MaxRanger/Satellite-Tracker/PCB/HostBoard/HostBoard_PowerPlane.kicad_pcb

## KiCad design PCB/HostBoard/HostBoard_PowerPlane.kicad_pcb (2025-11-15)

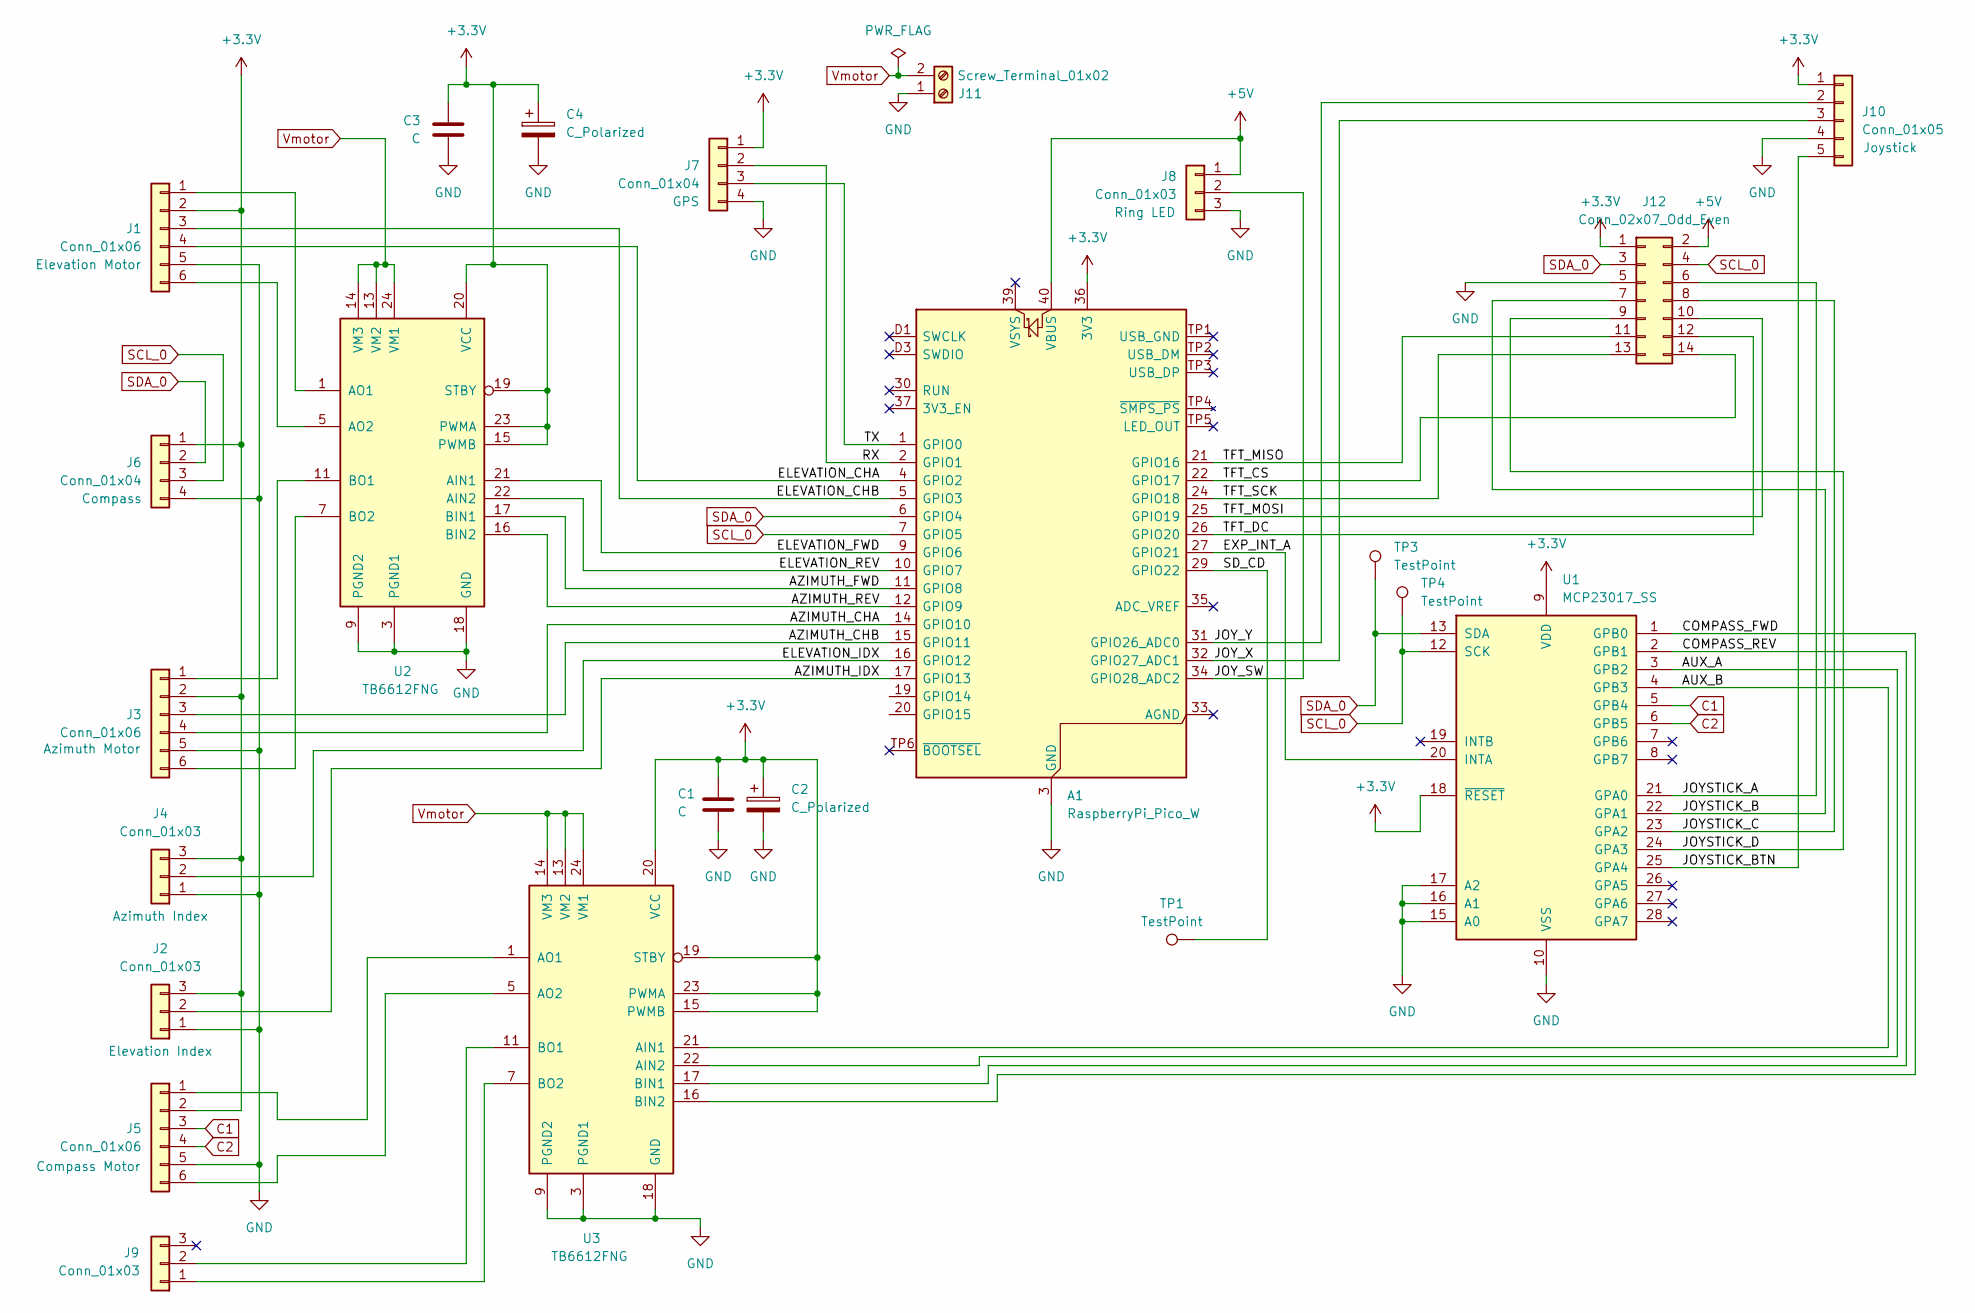
[picture p1: schematic HostBoard_PowerPlane.kicad_sch]

Parts:
A1: RaspberryPi_Pico_W; RaspberryPi_Pico_Common_THT
C1, C3: C; C_0805_2012Metric_Pad1.18x1.45mm_HandSolder
C2, C4: C_Polarized; C_0805_2012Metric_Pad1.18x1.45mm_HandSolder
J1, J3, J5: Conn_01x06; JST_EH_S6B-EH_1x06_P2.50mm_Horizontal
J2, J4, J8: Conn_01x03; JST_EH_S3B-EH_1x03_P2.50mm_Horizontal
J6, J7: Conn_01x04; JST_EH_S4B-EH_1x04_P2.50mm_Horizontal
J9: Conn_01x03; PinHeader_1x03_P2.54mm_Vertical
J10: Conn_01x05; JST_EH_S5B-EH_1x05_P2.50mm_Horizontal
J11: Screw_Terminal_01x02; TerminalBlock_Xinya_XY308-2.54-2P_1x02_P2.54mm_Horizontal
J12: Conn_02x07_Odd_Even; PinHeader_2x07_P2.54mm_Vertical
TP1: TestPoint; PinHeader_1x01_P2.54mm_Vertical
TP3, TP4: TestPoint; TestPoint_Pad_1.0x1.0mm
U1: MCP23017_SS; SSOP-28_5.3x10.2mm_P0.65mm
U2, U3: TB6612FNG; SSOP-24_5.3x8.2mm_P0.65mm

Connections:
+3.3V: A1.36 (3V3), C1.1, C2.1, C3.1, C4.1, J1.2, J2.3, J3.2, J4.3, J5.2, J6.1, J7.1, J10.1, J12.1, U1.9 (VDD), U1.18 (~RESET), U2.15 (PWMB), U2.19 (STBY), U2.20 (VCC), U2.23 (PWMA), U3.15 (PWMB), U3.19 (STBY), U3.20 (VCC), U3.23 (PWMA)
+5V: A1.40 (VBUS), J8.1, J12.2
/AZIMUTH_CHA: A1.14 (GPIO10), J3.4
/AZIMUTH_CHB: A1.15 (GPIO11), J3.3
/AZIMUTH_FWD: A1.11 (GPIO8), U2.17 (BIN1)
/AZIMUTH_IDX: A1.17 (GPIO13), J2.2
/AZIMUTH_REV: A1.12 (GPIO9), U2.16 (BIN2)
/ELEVATION_CHA: A1.4 (GPIO2), J1.4
/ELEVATION_CHB: A1.5 (GPIO3), J1.3
/ELEVATION_FWD: A1.9 (GPIO6), U2.21 (AIN1)
/ELEVATION_IDX: A1.16 (GPIO12), J4.2
/ELEVATION_REV: A1.10 (GPIO7), U2.22 (AIN2)
/EXP_INT_A: A1.27 (GPIO21), U1.20 (INTA)
/JOY_SW: A1.34 (GPIO28_ADC2), J8.2
/JOY_X: A1.32 (GPIO27_ADC1), J10.3
/JOY_Y: A1.31 (GPIO26_ADC0), J10.2
/RX: A1.2 (GPIO1), J7.2
/SD_CD: A1.29 (GPIO22), TP1.1
/TFT_CS: A1.22 (GPIO17), J12.14
/TFT_DC: A1.26 (GPIO20), J12.12
/TFT_MISO: A1.21 (GPIO16), J12.11
/TFT_MOSI: A1.25 (GPIO19), J12.10
/TFT_SCK: A1.24 (GPIO18), J12.13
/TX: A1.1 (GPIO0), J7.3
C1: J5.3, U1.5 (GPB4)
C2: J5.4, U1.6 (GPB5)
GND: A1.3 (GND), A1.8 (GND), A1.13 (GND), A1.18 (GND), A1.23 (GND), A1.28 (GND), A1.38 (GND), A1.D2 (GND), C1.2, C2.2, C3.2, C4.2, J1.5, J2.1, J3.5, J4.1, J5.5, J6.4, J7.4, J8.3, J10.4, J11.1, J12.5, U1.10 (VSS), U1.15 (A0), U1.16 (A1), U1.17 (A2), U2.3 (PGND1), U2.4 (PGND1), U2.9 (PGND2), U2.10 (PGND2), U2.18 (GND), U3.3 (PGND1), U3.4 (PGND1), U3.9 (PGND2), U3.10 (PGND2), U3.18 (GND)
unnamed: J1.1, U2.1 (AO1), U2.2 (AO1)
unnamed: J1.6, U2.5 (AO2), U2.6 (AO2)
unnamed: J3.1, U2.11 (BO1), U2.12 (BO1)
unnamed: J3.6, U2.7 (BO2), U2.8 (BO2)
unnamed: J5.1, U3.1 (AO1), U3.2 (AO1)
unnamed: J5.6, U3.5 (AO2), U3.6 (AO2)
unnamed: J9.1, U3.7 (BO2), U3.8 (BO2)
unnamed: J9.2, U3.11 (BO1), U3.12 (BO1)
unnamed: J10.5, U1.25 (GPA4)
unnamed: J12.6, U1.21 (GPA0)
unnamed: J12.7, U1.22 (GPA1)
unnamed: J12.8, U1.23 (GPA2)
unnamed: J12.9, U1.24 (GPA3)
unnamed: U1.1 (GPB0), U3.16 (BIN2)
unnamed: U1.2 (GPB1), U3.17 (BIN1)
unnamed: U1.3 (GPB2), U3.22 (AIN2)
unnamed: U1.4 (GPB3), U3.21 (AIN1)
SCL_0: A1.7 (GPIO5), J6.3, J12.4, TP4.1, U1.12 (SCK)
SDA_0: A1.6 (GPIO4), J6.2, J12.3, TP3.1, U1.13 (SDA)
Vmotor: J11.2, U2.13 (VM2), U2.14 (VM3), U2.24 (VM1), U3.13 (VM2), U3.14 (VM3), U3.24 (VM1)

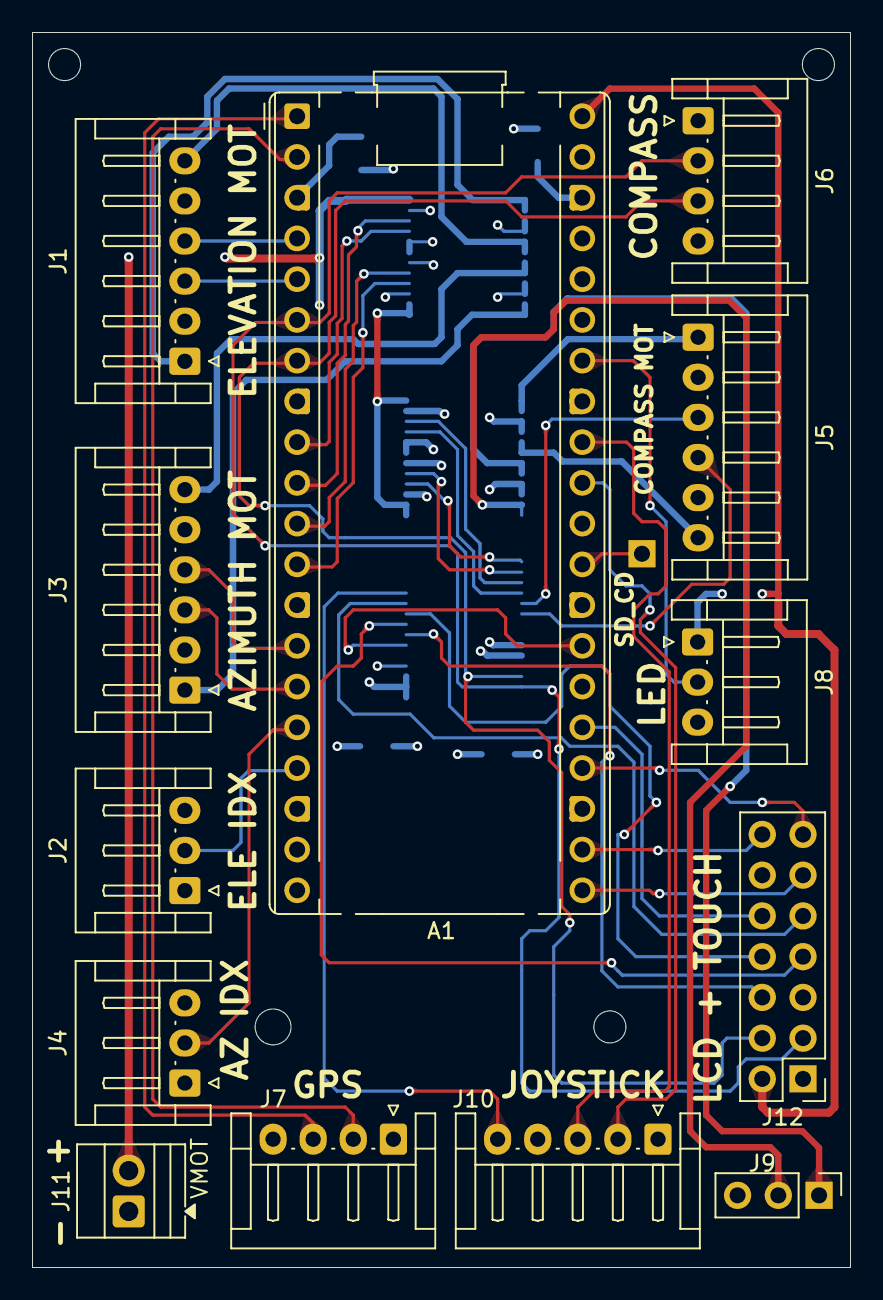
[picture p2: board HostBoard_PowerPlane.kicad_pcb from above]

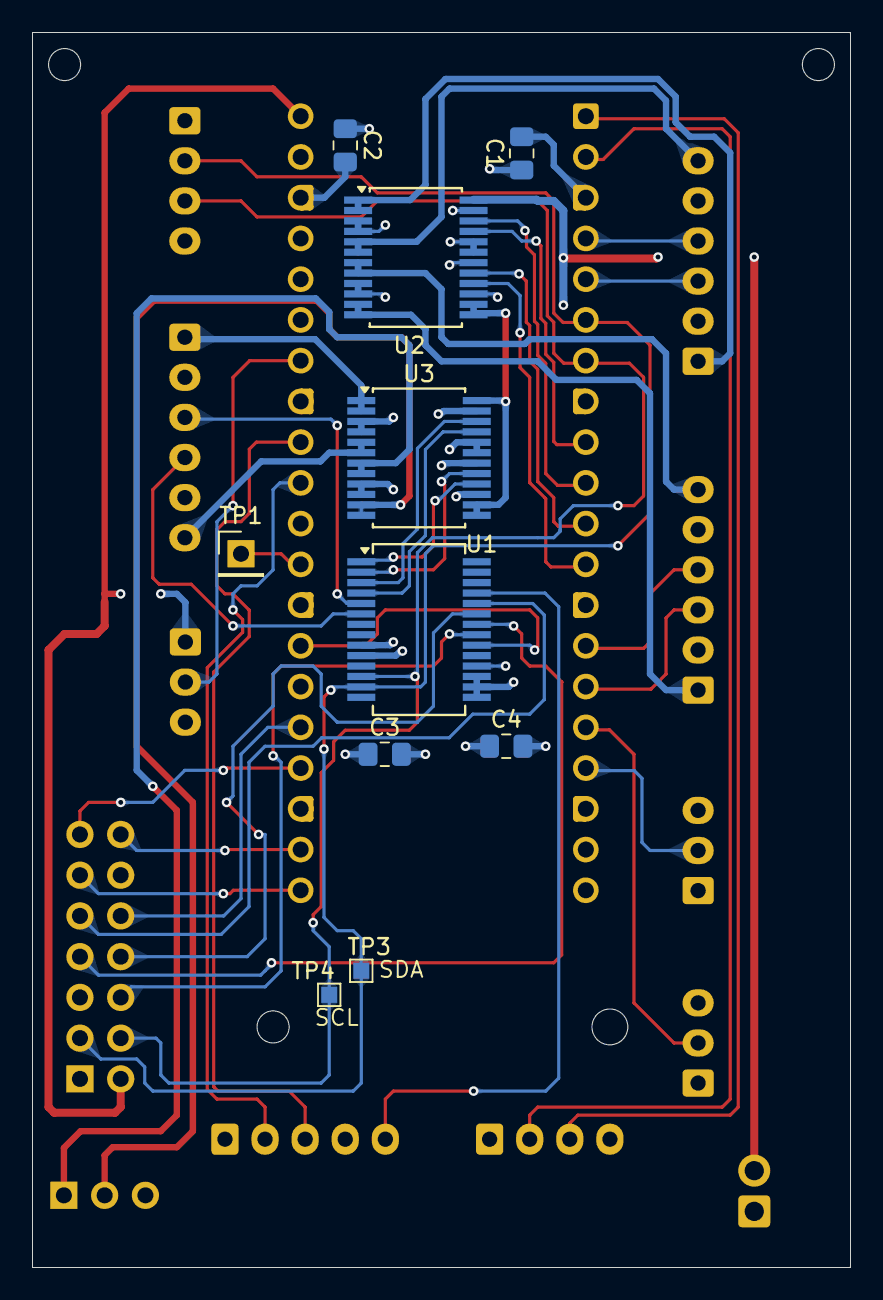
[picture p3: board HostBoard_PowerPlane.kicad_pcb from below]

Board: 4 copper layers, 51.0 x 77.0 mm, 23 parts (10 on the bottom side), 47 nets.
