MaxRanger/Satellite-Tracker/src/motor_control.cpp

// ============================================================================
// motor_control.cpp
// ============================================================================

#include "motor_control.h"

PIO pioEncoder = pio0;
uint smElevation;
uint smAzimuth;

// Emergency stop flag
volatile bool emergencyStop = false;

void setupPIOEncoders() {
  // Load PIO program
  uint offset = pio_add_program(pioEncoder, &quadrature_encoder_program);
  
  // Configure elevation encoder
  smElevation = 0;
  quadrature_encoder_program_init(pioEncoder, smElevation, offset, ENCODER_E_BASE, 0);
  
  // Configure azimuth encoder
  smAzimuth = 1;
  quadrature_encoder_program_init(pioEncoder, smAzimuth, offset, ENCODER_A_BASE, 0);
}

int32_t readPIOEncoder(uint sm) {
  quadrature_encoder_request_count(pioEncoder, sm);
  while (pio_sm_is_rx_fifo_empty(pioEncoder, sm));
  return quadrature_encoder_fetch_count(pioEncoder, sm);
}

void __not_in_flash_func(indexE_ISR)() {
  pio_sm_exec(pioEncoder, smElevation, pio_encode_set(pio_x, 0));
  motorPos.elevationIndexFound = true;
}

void __not_in_flash_func(indexA_ISR)() {
  pio_sm_exec(pioEncoder, smAzimuth, pio_encode_set(pio_x, 0));
  motorPos.azimuthIndexFound = true;
}

void __not_in_flash_func(emergencyStop_ISR)() {
  emergencyStop = true;
  // Immediately stop motors in ISR for fastest response
  #if MOTOR_BRAKE_MODE
    analogWrite(MOTOR_E_PWM_FWD, 255);
    analogWrite(MOTOR_E_PWM_REV, 255);
    analogWrite(MOTOR_A_PWM_FWD, 255);
    analogWrite(MOTOR_A_PWM_REV, 255);
  #else
    analogWrite(MOTOR_E_PWM_FWD, 0);
    analogWrite(MOTOR_E_PWM_REV, 0);
    analogWrite(MOTOR_A_PWM_FWD, 0);
    analogWrite(MOTOR_A_PWM_REV, 0);
  #endif
  
  trackerState.tracking = false;
}

void resetEmergencyStop() {
  emergencyStop = false;
  Serial.println("Emergency stop reset");
}

bool isEmergencyStop() {
  return emergencyStop;
}

void setMotorEnable(int enablePin, bool enable) {
#if MOTOR_USE_ENABLE_PINS
  #if MOTOR_ENABLE_ACTIVE_HIGH
    digitalWrite(enablePin, enable ? HIGH : LOW);
  #else
    digitalWrite(enablePin, enable ? LOW : HIGH);
  #endif
#endif
}

void setMotorSpeed(int fwdPin, int revPin, int enablePin, int speed) {
  // Check emergency stop
  if (emergencyStop) {
    speed = 0;
  }
  
  speed = constrain(speed, -255, 255);
  
  if (abs(speed) > 0 && abs(speed) < MOTOR_MIN_PWM) {
    speed = (speed > 0) ? MOTOR_MIN_PWM : -MOTOR_MIN_PWM;
  }
  
  #if MOTOR_USE_ENABLE_PINS
    setMotorEnable(enablePin, true);
  #endif
  
  if (speed > 0) {
    analogWrite(fwdPin, speed);
    analogWrite(revPin, 0);
  } else if (speed < 0) {
    analogWrite(fwdPin, 0);
    analogWrite(revPin, -speed);
  } else {
    #if MOTOR_BRAKE_MODE
      analogWrite(fwdPin, 255);
      analogWrite(revPin, 255);
    #else
      analogWrite(fwdPin, 0);
      analogWrite(revPin, 0);
    #endif
  }
}

void stopAllMotors() {
  setMotorSpeed(MOTOR_E_PWM_FWD, MOTOR_E_PWM_REV, MOTOR_E_ENABLE, 0);
  setMotorSpeed(MOTOR_A_PWM_FWD, MOTOR_A_PWM_REV, MOTOR_A_ENABLE, 0);
  
  #if MOTOR_USE_ENABLE_PINS
    setMotorEnable(MOTOR_E_ENABLE, false);
    setMotorEnable(MOTOR_A_ENABLE, false);
  #endif
}

float pidControl(float error, float &errorIntegral, float &lastError, float dt) {
  errorIntegral += error * dt;
  errorIntegral = constrain(errorIntegral, -MAX_ERROR_INTEGRAL, MAX_ERROR_INTEGRAL);
  
  float errorDerivative = (error - lastError) / dt;
  lastError = error;
  
  float output = KP * error + KI * errorIntegral + KD * errorDerivative;
  return constrain(output, -255, 255);
}

void updateMotorControl() {
  // Check emergency stop first
  if (emergencyStop) {
    stopAllMotors();
    return;
  }
  
  motorPos.elevation = readPIOEncoder(smElevation);
  motorPos.azimuth = readPIOEncoder(smAzimuth);
  
  float currentElevation = motorPos.elevation * DEGREES_PER_PULSE;
  float currentAzimuth = motorPos.azimuth * DEGREES_PER_PULSE;
  
  // Normalize azimuth to 0-360
  while (currentAzimuth < 0) currentAzimuth += 360.0;
  while (currentAzimuth >= 360) currentAzimuth -= 360.0;
  
  // Safety check: Elevation limits with margin
  if (currentElevation < (MIN_ELEVATION - 5.0) || 
      currentElevation > (MAX_ELEVATION + 5.0)) {
    Serial.print("ERROR: Elevation out of safe range: ");
    Serial.println(currentElevation);
    stopAllMotors();
    trackerState.tracking = false;
    return;
  }
  
  float targetEl = constrain(targetPos.elevation, MIN_ELEVATION, MAX_ELEVATION);
  float targetAz = targetPos.azimuth;
  
  float errorE = targetEl - currentElevation;
  float errorA = targetAz - currentAzimuth;
  
  // Handle azimuth wraparound (find shortest path)
  if (errorA > 180) errorA -= 360;
  if (errorA < -180) errorA += 360;
  
  float controlE = 0, controlA = 0;
  
  if (abs(errorE) > POSITION_TOLERANCE) {
    controlE = pidControl(errorE, errorIntegralE, lastErrorE, CONTROL_LOOP_DT);
  } else {
    errorIntegralE = 0;
    lastErrorE = 0;
  }
  
  if (abs(errorA) > POSITION_TOLERANCE) {
    controlA = pidControl(errorA, errorIntegralA, lastErrorA, CONTROL_LOOP_DT);
  } else {
    errorIntegralA = 0;
    lastErrorA = 0;
  }
  
  setMotorSpeed(MOTOR_E_PWM_FWD, MOTOR_E_PWM_REV, MOTOR_E_ENABLE, (int)controlE);
  setMotorSpeed(MOTOR_A_PWM_FWD, MOTOR_A_PWM_REV, MOTOR_A_ENABLE, (int)controlA);
}

void homeAxes() {
  Serial.println("Homing axes...");
  trackerState.tracking = false;
  
  // Reset emergency stop if needed
  if (emergencyStop) {
    Serial.println("Cannot home - emergency stop active");
    return;
  }
  
  // Home elevation axis
  motorPos.elevationIndexFound = false;
  setMotorSpeed(MOTOR_E_PWM_FWD, MOTOR_E_PWM_REV, MOTOR_E_ENABLE, -80);
  unsigned long startTime = millis();
  
  while (!motorPos.elevationIndexFound && 
         (millis() - startTime) < 30000 && 
         !emergencyStop) {
    delay(10);
  }
  setMotorSpeed(MOTOR_E_PWM_FWD, MOTOR_E_PWM_REV, MOTOR_E_ENABLE, 0);
  
  if (emergencyStop) {
    Serial.println("Homing aborted - emergency stop");
    return;
  }
  
  if (motorPos.elevationIndexFound) {
    Serial.println("Elevation homed");
  } else {
    Serial.println("ERROR: Elevation home timeout");
    return;
  }
  
  // Home azimuth axis
  motorPos.azimuthIndexFound = false;
  setMotorSpeed(MOTOR_A_PWM_FWD, MOTOR_A_PWM_REV, MOTOR_A_ENABLE, -80);
  startTime = millis();
  
  while (!motorPos.azimuthIndexFound && 
         (millis() - startTime) < 30000 && 
         !emergencyStop) {
    delay(10);
  }
  setMotorSpeed(MOTOR_A_PWM_FWD, MOTOR_A_PWM_REV, MOTOR_A_ENABLE, 0);
  
  if (emergencyStop) {
    Serial.println("Homing aborted - emergency stop");
    return;
  }
  
  if (motorPos.azimuthIndexFound) {
    Serial.println("Azimuth homed");
  } else {
    Serial.println("ERROR: Azimuth home timeout");
    return;
  }
  
  delay(500);
  Serial.println("Homing complete");
}

void initMotorControl() {
  Serial.println("Initializing motor control...");
  
  setupPIOEncoders();
  Serial.println("PIO encoders initialized");
  
  pinMode(MOTOR_E_PWM_FWD, OUTPUT);
  pinMode(MOTOR_E_PWM_REV, OUTPUT);
  pinMode(MOTOR_A_PWM_FWD, OUTPUT);
  pinMode(MOTOR_A_PWM_REV, OUTPUT);
  
  #if MOTOR_USE_ENABLE_PINS
    pinMode(MOTOR_E_ENABLE, OUTPUT);
    pinMode(MOTOR_A_ENABLE, OUTPUT);
    setMotorEnable(MOTOR_E_ENABLE, false);
    setMotorEnable(MOTOR_A_ENABLE, false);
  #endif
  
  analogWriteFreq(PWM_FREQUENCY);
  analogWriteResolution(PWM_RESOLUTION);
  
  stopAllMotors();
  
  // Setup index pins
  pinMode(INDEX_E, INPUT_PULLUP);
  pinMode(INDEX_A, INPUT_PULLUP);
  attachInterrupt(digitalPinToInterrupt(INDEX_E), indexE_ISR, FALLING);
  attachInterrupt(digitalPinToInterrupt(INDEX_A), indexA_ISR, FALLING);
  
  // Setup emergency stop pin
  //pinMode(EMERGENCY_STOP_PIN, INPUT_PULLUP);
  //attachInterrupt(digitalPinToInterrupt(EMERGENCY_STOP_PIN), emergencyStop_ISR, FALLING);
  
  emergencyStop = false;
  
  Serial.println("Motor control initialized");
  Serial.println("Emergency stop pin configured");
}

void printMotorStatus() {
  Serial.println(F("\n=== MOTOR STATUS ==="));
  Serial.println();
  
  float currentEl = motorPos.elevation * DEGREES_PER_PULSE;
  float currentAz = motorPos.azimuth * DEGREES_PER_PULSE;
  while (currentAz < 0) currentAz += 360.0;
  while (currentAz >= 360) currentAz -= 360.0;
  
  Serial.printf("Current Position:\n");
  Serial.printf("  Azimuth:   %.2f° (encoder: %ld)\n", currentAz, motorPos.azimuth);
  Serial.printf("  Elevation: %.2f° (encoder: %ld)\n", currentEl, motorPos.elevation);
  
  Serial.println();
  Serial.printf("Target Position:\n");
  Serial.printf("  Azimuth:   %.2f°\n", targetPos.azimuth);
  Serial.printf("  Elevation: %.2f°\n", targetPos.elevation);
  Serial.printf("  Valid:     %s\n", targetPos.valid ? "YES" : "NO");
  
  Serial.println();
  Serial.printf("Position Error:\n");
  float errorAz = targetPos.azimuth - currentAz;
  if (errorAz > 180) errorAz -= 360;
  if (errorAz < -180) errorAz += 360;
  float errorEl = targetPos.elevation - currentEl;
  Serial.printf("  Azimuth:   %.2f°\n", errorAz);
  Serial.printf("  Elevation: %.2f°\n", errorEl);
  
  Serial.println();
  Serial.printf("Index Found:\n");
  Serial.printf("  Azimuth:   %s\n", motorPos.azimuthIndexFound ? "YES" : "NO");
  Serial.printf("  Elevation: %s\n", motorPos.elevationIndexFound ? "YES" : "NO");
  
  Serial.println();
  Serial.printf("Emergency Stop: %s\n", isEmergencyStop() ? "ACTIVE" : "OK");
  
  Serial.println();
}

void printEncoderCounts() {
  Serial.println(F("\n=== ENCODER COUNTS ==="));
  Serial.println();
  
  Serial.printf("Azimuth Encoder:   %ld counts (%.2f°)\n",
                motorPos.azimuth,
                motorPos.azimuth * DEGREES_PER_PULSE);
  
  Serial.printf("Elevation Encoder: %ld counts (%.2f°)\n",
                motorPos.elevation,
                motorPos.elevation * DEGREES_PER_PULSE);
  
  Serial.println();
  Serial.printf("Degrees per count: %.6f°\n", DEGREES_PER_PULSE);
  Serial.printf("Gear ratio:        %.1f:1\n", GEAR_RATIO);
  Serial.printf("Encoder PPR:       %d\n", ENCODER_PPR);
  Serial.println();
}
