MaxRanger/Satellite-Tracker/src/joystick_module.cpp

// ============================================================================
// joystick_module.cpp - Analog joystick implementation (no button)
// ============================================================================

#include "joystick_module.h"

// Current joystick state (button fields removed)
static JoystickData currentState = {0, 0, 0.0, 0.0, true};

// Calibration data
static JoystickCalibration calibration = {
  0,      // xMin
  2048,   // xCenter (12-bit ADC midpoint)
  4095,   // xMax
  0,      // yMin
  2048,   // yCenter
  4095,   // yMax
  10      // deadband (10% default)
};

// Calibration state
static bool calibrating = false;
static uint16_t calXMin = 4095, calXMax = 0;
static uint16_t calYMin = 4095, calYMax = 0;
static uint32_t calXSum = 0, calYSum = 0;
static uint16_t calSampleCount = 0;

// Manual mode state - now controlled externally (not by joystick button)
static bool manualModeActive = false;

// ============================================================================
// INTERNAL FUNCTIONS
// ============================================================================

// Apply deadband and normalize value
static float applyDeadbandAndNormalize(int16_t raw, uint16_t min, uint16_t center, uint16_t max, uint16_t deadbandPercent) {
  // Calculate deadband threshold
  uint16_t rangeHalf = (max - min) / 2;
  uint16_t deadbandRange = (rangeHalf * deadbandPercent) / 100;
  
  // Convert raw to signed offset from center
  int16_t offset = raw - center;
  
  // Apply deadband
  if (abs(offset) < deadbandRange) {
    return 0.0;
  }
  
  // Normalize to -1.0 to +1.0
  float normalized;
  if (offset > 0) {
    // Positive side
    normalized = (float)(offset - deadbandRange) / (float)(max - center - deadbandRange);
  } else {
    // Negative side
    normalized = (float)(offset + deadbandRange) / (float)(center - min - deadbandRange);
  }
  
  // Clamp to -1.0 to +1.0
  return constrain(normalized, -1.0, 1.0);
}

// Check if value is in deadband
static bool isInDeadband(int16_t raw, uint16_t center, uint16_t range, uint16_t deadbandPercent) {
  int16_t offset = abs(raw - center);
  uint16_t deadbandRange = (range * deadbandPercent) / 100;
  return offset < deadbandRange;
}

// Read raw ADC values (no button)
static void readRawJoystick(uint16_t* x, uint16_t* y) {
  *x = analogRead(JOYSTICK_X_PIN);
  *y = analogRead(JOYSTICK_Y_PIN);
}

// ============================================================================
// PUBLIC API IMPLEMENTATION
// ============================================================================

void initJoystick() {
  Serial.println("Initializing joystick...");
  
  // Configure analog pins (RP2040/RP2350 has 12-bit ADC)
  analogReadResolution(12);  // 0-4095 range
  pinMode(JOYSTICK_X_PIN, INPUT);
  pinMode(JOYSTICK_Y_PIN, INPUT);
  
  // No button pin configuration (button is now E-Stop)
  
  // Read initial center position
  uint16_t x, y;
  
  // Average multiple samples for center calibration
  uint32_t xSum = 0, ySum = 0;
  for (int i = 0; i < 10; i++) {
    readRawJoystick(&x, &y);
    xSum += x;
    ySum += y;
    delay(10);
  }
  
  calibration.xCenter = xSum / 10;
  calibration.yCenter = ySum / 10;
  
  Serial.println("Joystick initialized");
  Serial.printf("  X pin: GPIO %d, Center: %d\n", JOYSTICK_X_PIN, calibration.xCenter);
  Serial.printf("  Y pin: GPIO %d, Center: %d\n", JOYSTICK_Y_PIN, calibration.yCenter);
  Serial.printf("  Deadband: %d%%\n", calibration.deadband);
  Serial.println("  Note: Joystick button is now Emergency Stop (GP23)");
}

JoystickData readJoystick() {
  uint16_t rawX, rawY;
  
  readRawJoystick(&rawX, &rawY);
  
  // Update state
  currentState.x = rawX;
  currentState.y = rawY;
  
  // Normalize values with deadband
  currentState.xNormalized = applyDeadbandAndNormalize(
    rawX,
    calibration.xMin,
    calibration.xCenter,
    calibration.xMax,
    calibration.deadband
  );
  
  currentState.yNormalized = applyDeadbandAndNormalize(
    rawY,
    calibration.yMin,
    calibration.yCenter,
    calibration.yMax,
    calibration.deadband
  );
  
  // Check if in deadband
  uint16_t xRange = (calibration.xMax - calibration.xMin) / 2;
  uint16_t yRange = (calibration.yMax - calibration.yMin) / 2;
  bool xInDeadband = isInDeadband(rawX, calibration.xCenter, xRange, calibration.deadband);
  bool yInDeadband = isInDeadband(rawY, calibration.yCenter, yRange, calibration.deadband);
  currentState.inDeadband = xInDeadband && yInDeadband;
  
  return currentState;
}

JoystickData getJoystickState() {
  return currentState;
}

bool isJoystickCentered() {
  return currentState.inDeadband;
}

float getJoystickAzimuthSpeed() {
  // Only return speed if manual mode is active
  if (!manualModeActive) {
    return 0.0f;
  }
  
  // X axis controls azimuth
  // Right (higher value) = positive speed (clockwise)
  // Left (lower value) = negative speed (counterclockwise)
  return currentState.xNormalized;
}

float getJoystickElevationSpeed() {
  // Only return speed if manual mode is active
  if (!manualModeActive) {
    return 0.0f;
  }
  
  // Y axis controls elevation
  // Up (higher value) = positive speed (up)
  // Down (lower value) = negative speed (down)
  return currentState.yNormalized;
}

// Manual mode control - called by external systems (display/serial)
void setJoystickManualMode(bool active) {
  if (manualModeActive != active) {
    manualModeActive = active;
    Serial.print("Joystick manual mode: ");
    Serial.println(manualModeActive ? "ACTIVE" : "INACTIVE");
  }
}

bool isJoystickManualMode() {
  return manualModeActive;
}

// ============================================================================
// CALIBRATION IMPLEMENTATION
// ============================================================================

JoystickCalibration getJoystickCalibration() {
  return calibration;
}

void setJoystickCalibration(JoystickCalibration cal) {
  calibration = cal;
  Serial.println("Joystick calibration updated");
  Serial.printf("  X: [%d, %d, %d]\n", cal.xMin, cal.xCenter, cal.xMax);
  Serial.printf("  Y: [%d, %d, %d]\n", cal.yMin, cal.yCenter, cal.yMax);
  Serial.printf("  Deadband: %d%%\n", cal.deadband);
}

void startJoystickCalibration() {
  if (calibrating) {
    Serial.println("Calibration already in progress");
    return;
  }
  
  Serial.println("\n=== Joystick Calibration ===");
  Serial.println("Move joystick through full range");
  Serial.println("Then center it and wait for completion");
  
  calibrating = true;
  calXMin = 4095;
  calXMax = 0;
  calYMin = 4095;
  calYMax = 0;
  calXSum = 0;
  calYSum = 0;
  calSampleCount = 0;
}

void stopJoystickCalibration() {
  if (!calibrating) {
    Serial.println("No calibration in progress");
    return;
  }
  
  calibrating = false;
  
  // Calculate center as average of samples
  if (calSampleCount > 0) {
    calibration.xCenter = calXSum / calSampleCount;
    calibration.yCenter = calYSum / calSampleCount;
  }
  
  // Set min/max
  calibration.xMin = calXMin;
  calibration.xMax = calXMax;
  calibration.yMin = calYMin;
  calibration.yMax = calYMax;
  
  Serial.println("\n=== Calibration Complete ===");
  Serial.printf("X: Min=%d, Center=%d, Max=%d, Range=%d\n",
                calibration.xMin, calibration.xCenter, calibration.xMax,
                calibration.xMax - calibration.xMin);
  Serial.printf("Y: Min=%d, Center=%d, Max=%d, Range=%d\n",
                calibration.yMin, calibration.yCenter, calibration.yMax,
                calibration.yMax - calibration.yMin);
  Serial.printf("Deadband: %d%%\n", calibration.deadband);
  
  Serial.println("\nAdd to config for permanent calibration:");
  Serial.printf("xMin=%d, xCenter=%d, xMax=%d\n", calibration.xMin, calibration.xCenter, calibration.xMax);
  Serial.printf("yMin=%d, yCenter=%d, yMax=%d\n", calibration.yMin, calibration.yCenter, calibration.yMax);
}

bool isJoystickCalibrating() {
  return calibrating;
}

void updateJoystickCalibration() {
  if (!calibrating) {
    return;
  }
  
  uint16_t x, y;
  readRawJoystick(&x, &y);
  
  // Update min/max
  calXMin = min(calXMin, x);
  calXMax = max(calXMax, x);
  calYMin = min(calYMin, y);
  calYMax = max(calYMax, y);
  
  // Accumulate center samples
  calXSum += x;
  calYSum += y;
  calSampleCount++;
  
  // Print progress every 500ms
  static unsigned long lastPrint = 0;
  if (millis() - lastPrint >= 500) {
    Serial.printf("Cal: X:[%d-%d] Y:[%d-%d] Samples:%d\n",
                  calXMin, calXMax, calYMin, calYMax, calSampleCount);
    lastPrint = millis();
  }
}

void resetJoystickCalibration() {
  calibration.xMin = 0;
  calibration.xCenter = 2048;
  calibration.xMax = 4095;
  calibration.yMin = 0;
  calibration.yCenter = 2048;
  calibration.yMax = 4095;
  calibration.deadband = 10;
  
  Serial.println("Joystick calibration reset to defaults");
}

void setJoystickDeadband(uint16_t percent) {
  calibration.deadband = constrain(percent, 0, 50);  // Max 50%
  Serial.printf("Joystick deadband: %d%%\n", calibration.deadband);
}

// ============================================================================
// UTILITY FUNCTIONS
// ============================================================================

void updateJoystick() {
  // Read and process joystick
  readJoystick();
  
  // Update calibration if active
  if (calibrating) {
    updateJoystickCalibration();
  }
}

void printJoystickStatus() {
  Serial.println(F("\n=== JOYSTICK STATUS ==="));
  Serial.println();
  
  JoystickData joy = getJoystickState();
  JoystickCalibration cal = getJoystickCalibration();
  
  Serial.print(F("Manual Mode:   "));
  Serial.println(isJoystickManualMode() ? F("ACTIVE") : F("INACTIVE"));
  
  Serial.print(F("Calibrating:   "));
  Serial.println(isJoystickCalibrating() ? F("YES") : F("NO"));
  
  Serial.print(F("Centered:      "));
  Serial.println(joy.inDeadband ? F("YES") : F("NO"));
  
  Serial.println();
  Serial.println(F("Raw Values:"));
  
  // FIX: Use Serial.print() instead of printf for floats
  Serial.print(F("  X: "));
  Serial.print(joy.x);
  Serial.print(F(" (norm: "));
  Serial.print(joy.xNormalized, 3);
  Serial.println(F(")"));
  
  Serial.print(F("  Y: "));
  Serial.print(joy.y);
  Serial.print(F(" (norm: "));
  Serial.print(joy.yNormalized, 3);
  Serial.println(F(")"));
  
  Serial.println();
  Serial.println(F("Calibration:"));
  Serial.print(F("  X: Min="));
  Serial.print(cal.xMin);
  Serial.print(F(" Center="));
  Serial.print(cal.xCenter);
  Serial.print(F(" Max="));
  Serial.println(cal.xMax);
  
  Serial.print(F("  Y: Min="));
  Serial.print(cal.yMin);
  Serial.print(F(" Center="));
  Serial.print(cal.yCenter);
  Serial.print(F(" Max="));
  Serial.println(cal.yMax);
  
  Serial.print(F("  Deadband: "));
  Serial.print(cal.deadband);
  Serial.println(F("%"));
  
  Serial.println();
  Serial.println(F("Speed Commands:"));
  
  Serial.print(F("  Azimuth:   "));
  Serial.println(getJoystickAzimuthSpeed(), 3);
  
  Serial.print(F("  Elevation: "));
  Serial.println(getJoystickElevationSpeed(), 3);
  
  Serial.println();
}

void printRawJoystickData(int samples) {
  Serial.println(F("\n=== RAW JOYSTICK DATA ==="));
  Serial.printf("Collecting %d samples...\n", samples);
  Serial.println();
  Serial.println(F("Sample    X     Y     X_norm  Y_norm  Button"));
  Serial.println(F("------  ----  ----   ------  ------  ------"));
  
  for (int i = 0; i < samples; i++) {
    JoystickData joy = readJoystick();
    
    Serial.printf("%4d    %4d  %4d   %6.3f  %6.3f   %s\n",
                  i + 1,
                  joy.x,
                  joy.y,
                  joy.xNormalized,
                  joy.yNormalized);
//                  joy.buttonPressed ? "PRESS" : "REL");
    
    delay(100);
  }
  
  Serial.println();
}
