MaxRanger/Satellite-Tracker/(commit log)

2025-10-14 Refactor and enhance various modules: improved PIO encoder handling, added emergency stop functionality, refined GPS and tracking logic, and implemented a settings screen in the display module.
2025-10-15 Add stubs for the 4 momentary-contact switches on the LCD display module Move compass-related code to the compass module Add 2812 LED driver from PIO to give user state information
2025-10-15 Move pin assignments to avoid conflicts
    [Tracker RPI2350.cpp, config.h, gps_module.cpp]
2025-10-16 Add initial attempt at mDNS. Not working on Pixel 9 Android cell phone
    Fix problem - web server not started when WiFi is up
    [Tracker RPI2350.cpp, display_module.cpp, web_interface.cpp]
2025-10-17 Begin adding flash storage capability Add predictive tracking_logic Fix GPS communication to Serial 1
    [Tracker RPI2350.cpp, config.h, gps_module.cpp, storage_module.cpp, storage_module.h, tracking_logic.cpp]
2025-10-22 Add LED commands to the interactive serial console
2025-10-22 Debug 2812 LED ring
2025-10-22 Add more 2812 Ring LED debug info
2025-10-23 Fix LEDs. Still need to understand PIO shift out register, RGB vs BRG vs GRB bit ordering
    [Tracker RPI2350.cpp, led_module.cpp, led_module.h]
2025-10-30 Trying to get reprogram with having to press BOOT button. No luck.
2025-11-04 Add Host PCB. Will include Raspberry Pi Pico 2 W, motor controller, connectors for motors / axis index / joystick / GPS / compass / LCD / USB-C
    [HostBoard.kicad_pcb, HostBoard.kicad_sch]
2025-11-07 Add routing and second motor controller for automatic compass calibration. Without ability to multistep, not adding connectors for dual-use stepper motor / DC motor option.
    [HostBoard.kicad_sch]
2025-11-11 Continuing schematic entry
    [HostBoard.kicad_sch]
2025-11-11 Add interactive motor debug for tuning PID
2025-11-11 Cleanup and reorganization
    [HostBoard.kicad_sch]
2025-11-12 Footprints assigned. Start PCB layout. Need to finish tentative schematics pin assignments
    [HostBoard.kicad_pcb, HostBoard.kicad_sch]
2025-11-13 PCB Routing. Signals done except VMot and TPx. Need power planes, silk and outline
    [HostBoard.kicad_pcb, HostBoard.kicad_sch]
2025-11-14 Completed PCB for existing schematic, need to re-assign LCD and check schematic
    [HostBoard.kicad_pcb, HostBoard.kicad_sch]
2025-11-15 Moved TFT_DC and Expander INTA pins to match code
    [HostBoard.kicad_pcb, HostBoard.kicad_sch]
2025-11-18 Add new PCB layout with two ground planes, no power planes, routing in N-S and E-W on top and bottom
    [HostBoard_DoubleGND.kicad_pcb, HostBoard_DoubleGND.kicad_sch]
2025-11-19 As sent to JLBPCB. $66.
    [HostBoard_DoubleGND.kicad_pcb, HostBoard_DoubleGND.kicad_sch]
2025-11-19 Renamed PCB with power plane. Note that this version is behind the double-ground version and is not intended to be updated. Double-ground was sent for manufacturing on 2025-Nov-18
    [HostBoard_PowerPlane.kicad_pcb, HostBoard_PowerPlane.kicad_sch]
