MaxRanger/Satellite-Tracker/(notices)

Notices in the files:
PCB/HostBoard/HostBoard_DoubleGND.kicad_pcb:
McA ©2025
